sciencetek-song/fx10/STEP/BUZ_CMI-9705-0580-SMT-TR.step

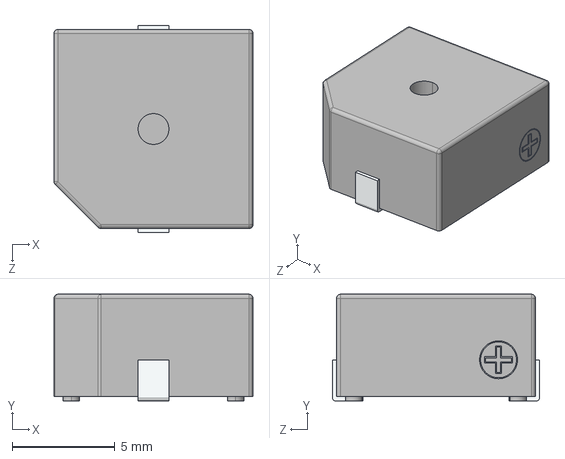
[picture p1: CAD file, 2025-09-14]
STEP/BUZ_CMI-9705-0580-SMT-TR.step
9.70 x 5.20 x 10.1 mm
