sciencetek-song/fx10/STEP/W25Q256JVEIQ.step

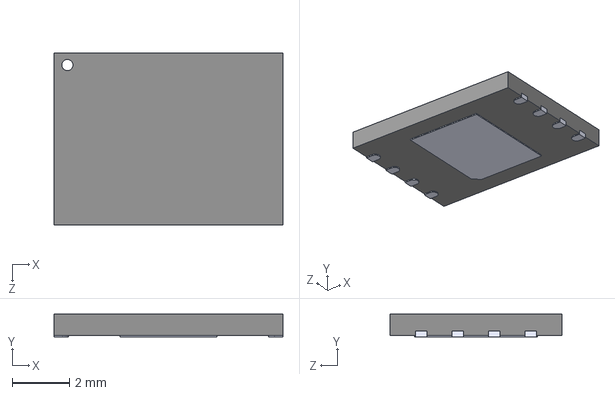
[picture p2: CAD file, 2025-09-14]
STEP/W25Q256JVEIQ.step
8.00 x 0.8 x 6.00 mm
