sciencetek-song/fx10/STEP/SMD14P.stp

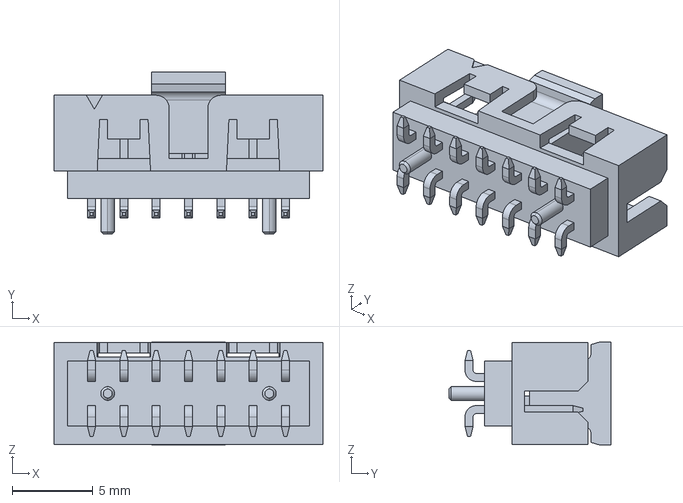
[picture p3: CAD file, 2025-09-14]
STEP/SMD14P.stp
16.6 x 10.0 x 6.35 mm
