sciencetek-song/fx10/STEP/TEST-PIN.step

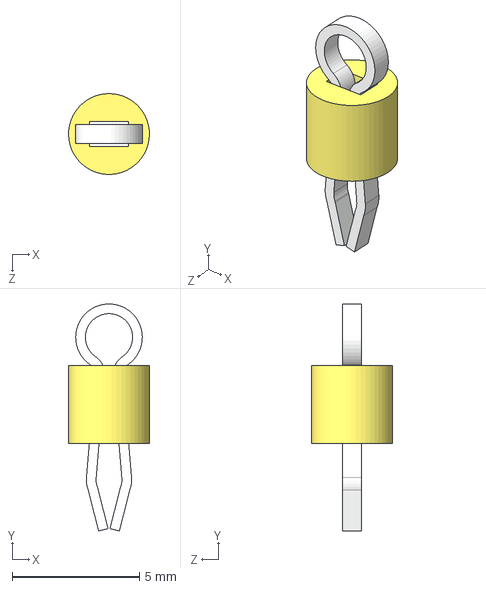
[picture p4: CAD file, 2025-09-14]
STEP/TEST-PIN.step
3.17 x 8.91 x 3.17 mm
