sciencetek-song/fx10/STEP/DS1307Z_.step

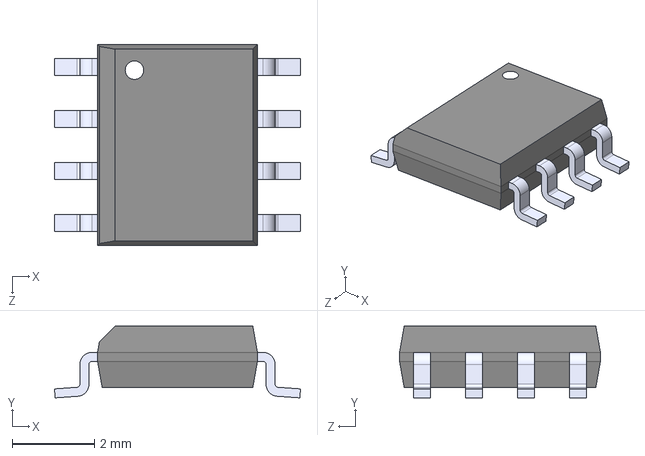
[picture p5: CAD file, 2025-09-14]
STEP/DS1307Z_.step
6.00 x 1.75 x 4.90 mm
