sciencetek-song/fx10/STEP/10UH.step

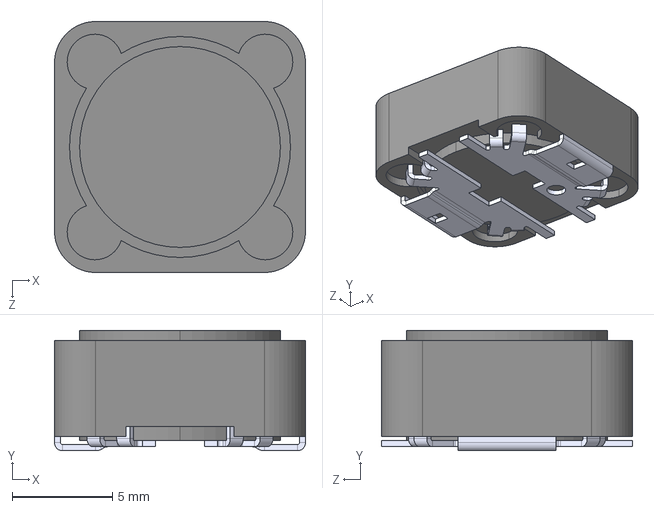
[picture p6: CAD file, 2025-09-14]
STEP/10UH.step
12.5 x 6.00 x 12.5 mm
