sciencetek-song/fx10/STEP/USBLC6-2SC6.step

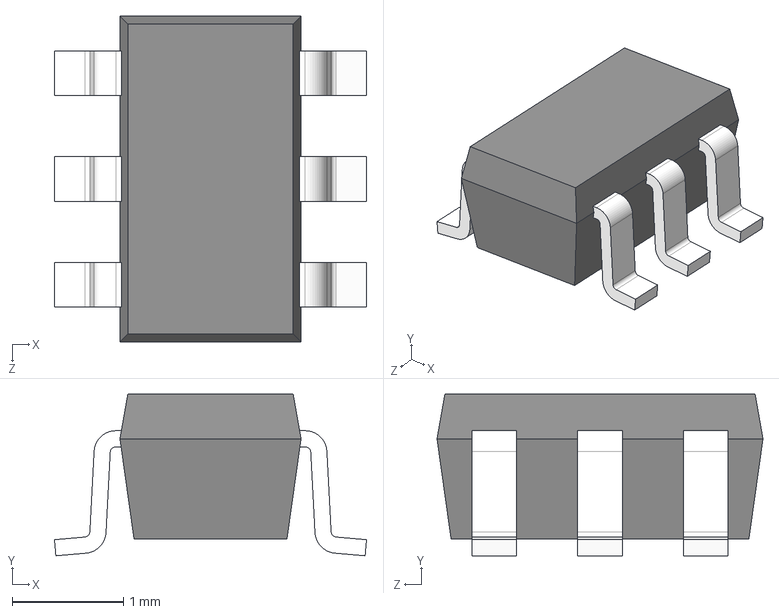
[picture p7: CAD file, 2025-09-14]
STEP/USBLC6-2SC6.step
2.80 x 1.45 x 2.92 mm
