sciencetek-song/fx10/STEP/LT3014ES5_TRPBF.step

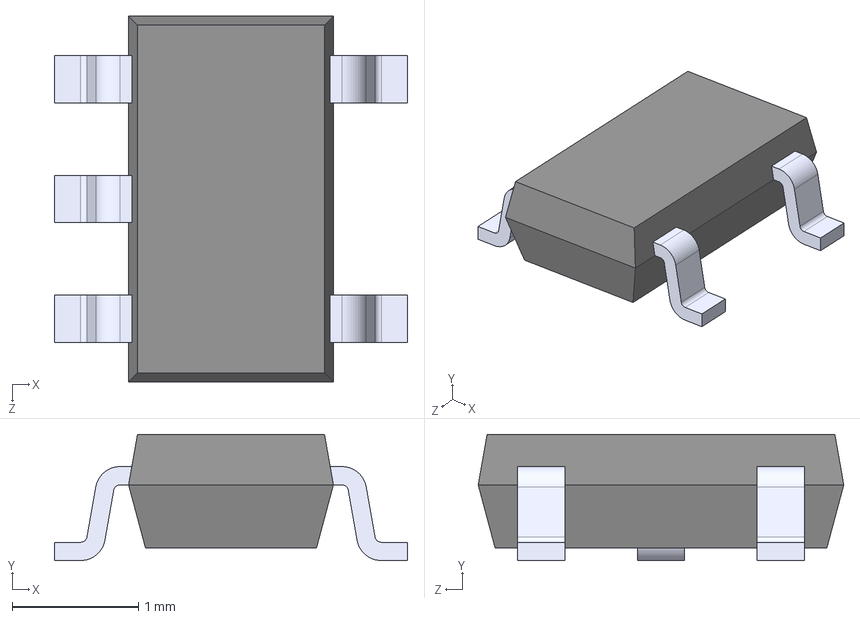
[picture p8: CAD file, 2025-09-14]
STEP/LT3014ES5_TRPBF.step
2.80 x 1.00 x 2.90 mm
