sciencetek-song/fx10/STEP/SDCARD-MOLEX.step

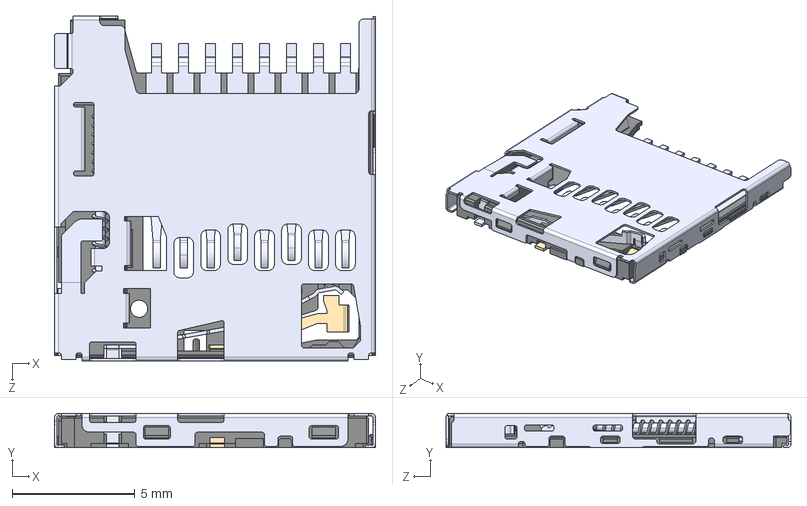
[picture p9: CAD file, 2025-09-14]
STEP/SDCARD-MOLEX.step
13.1 x 1.40 x 14.1 mm
