sciencetek-song/fx10/STEP/SS34.step

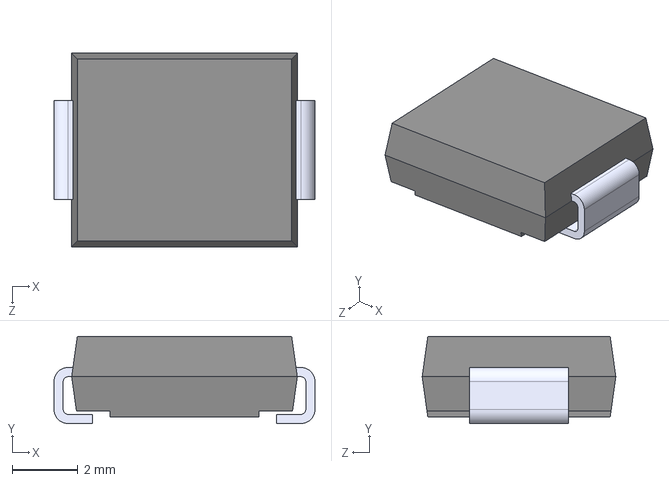
[picture p10: CAD file, 2025-09-14]
STEP/SS34.step
7.95 x 2.65 x 5.90 mm
