sciencetek-song/fx10/STEP/ADM8660ARZ-REEL.step

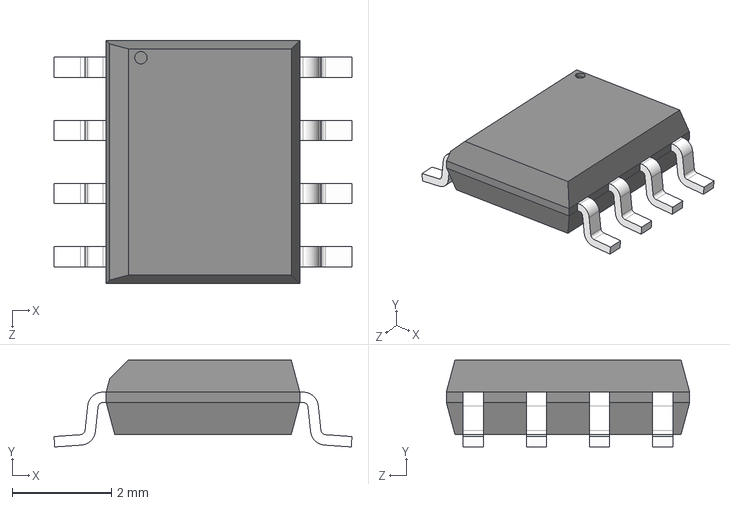
[picture p11: CAD file, 2025-09-14]
STEP/ADM8660ARZ-REEL.step
6.00 x 1.75 x 4.90 mm
