sciencetek-song/fx10/STEP/MMSZ5248BS-7-F.step

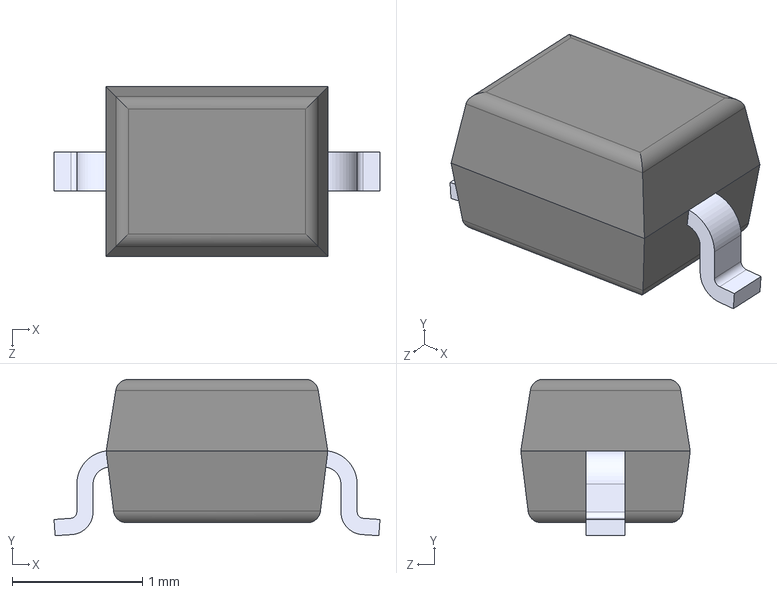
[picture p12: CAD file, 2025-09-14]
STEP/MMSZ5248BS-7-F.step
2.50 x 1.20 x 1.30 mm
