sciencetek-song/fx10/STEP/BLM18PG121SN1D.step

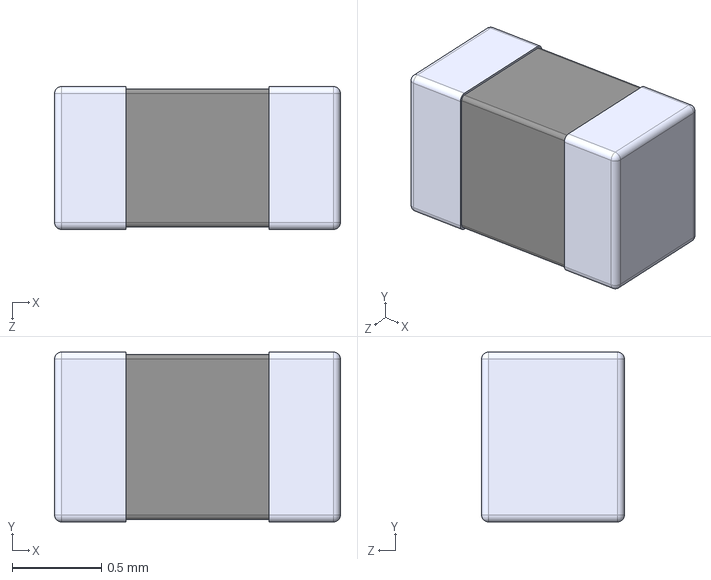
[picture p13: CAD file, 2025-09-14]
STEP/BLM18PG121SN1D.step
1.60 x 0.95 x 0.8 mm
