sciencetek-song/fx10/STEP/USBR-A-S-S-O-TH.stp

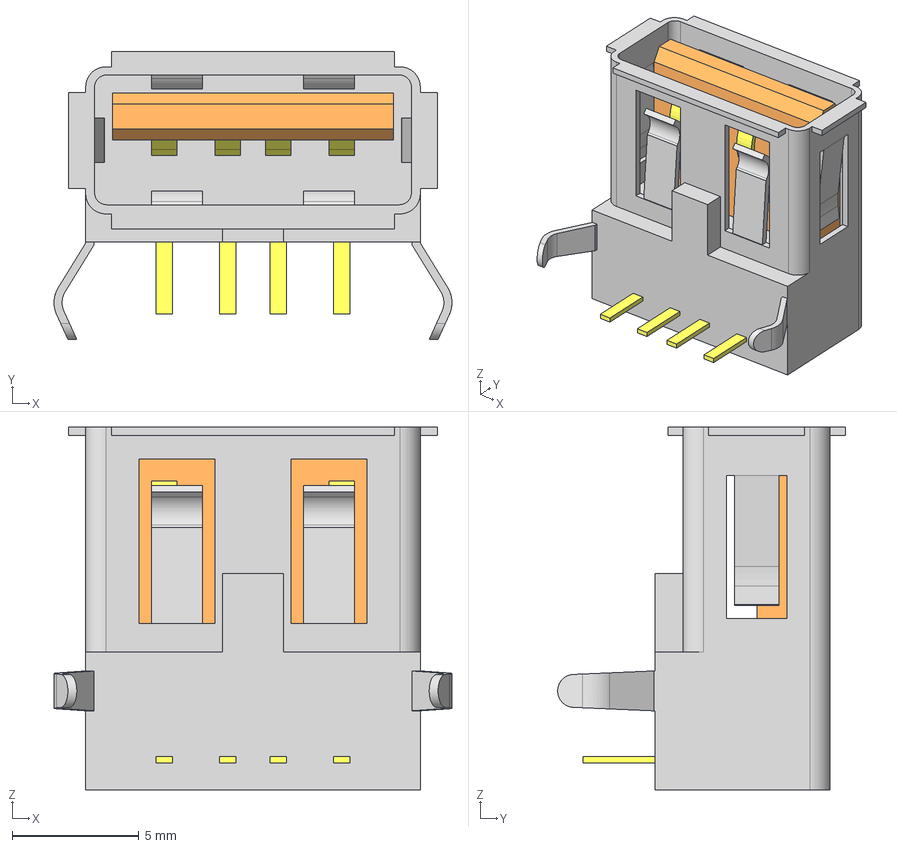
[picture p14: CAD file, 2025-09-14]
STEP/USBR-A-S-S-O-TH.stp
15.7 x 11.3 x 14.3 mm
USBR-A-S-TH_s
USBR-A-S-TH_b
USBR-A-S-TH_p
