sciencetek-song/fx10/STEP/BOX5x2_ANGLE2MM.step

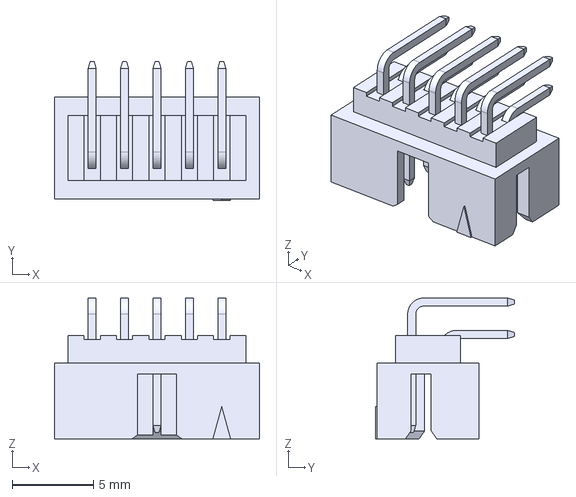
[picture p15: CAD file, 2025-09-14]
STEP/BOX5x2_ANGLE2MM.step
12.6 x 8.60 x 8.70 mm
