sciencetek-song/fx10/STEP/5267-02A-X.step

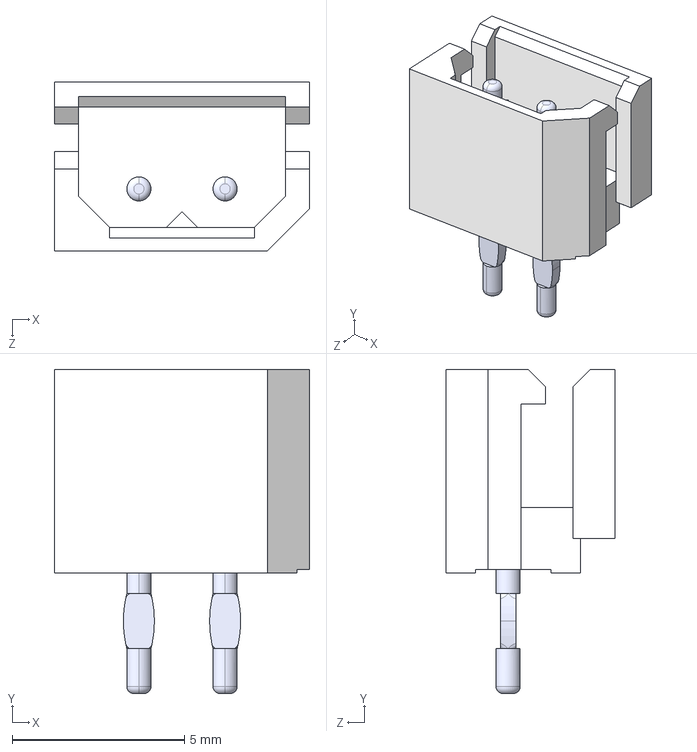
[picture p16: CAD file, 2025-09-14]
STEP/5267-02A-X.step
7.40 x 9.40 x 4.90 mm
