sciencetek-song/fx10/STEP/MMBT4401.step

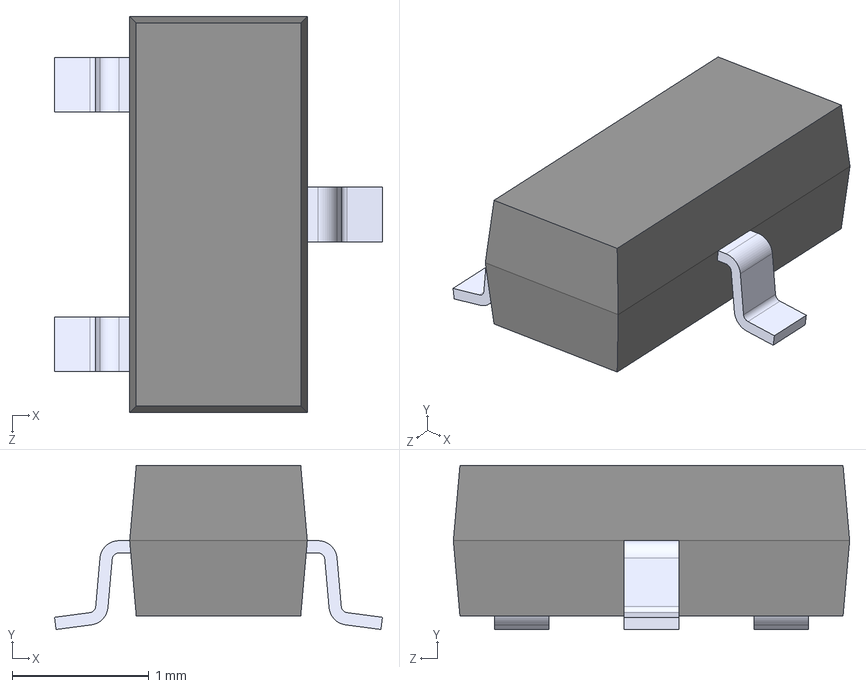
[picture p17: CAD file, 2025-09-14]
STEP/MMBT4401.step
2.40 x 1.20 x 2.90 mm
