sciencetek-song/fx10/STEP/BNX002-11.step

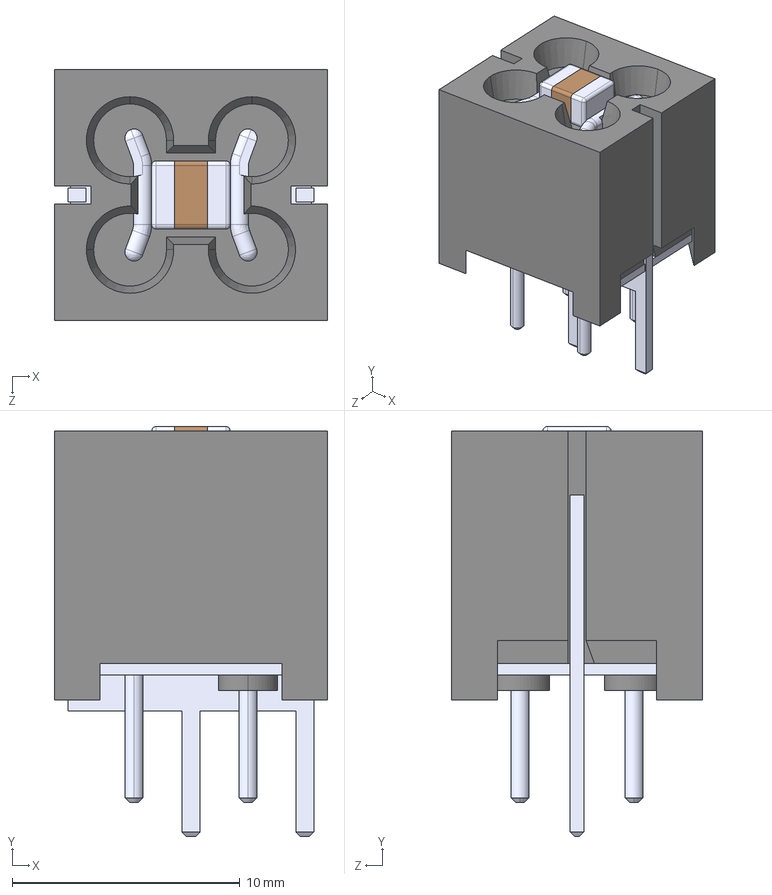
[picture p18: CAD file, 2025-09-14]
STEP/BNX002-11.step
12.0 x 18.0 x 11.0 mm
