sciencetek-song/fx10/STEP/AT24C512C-SSHD-T.step

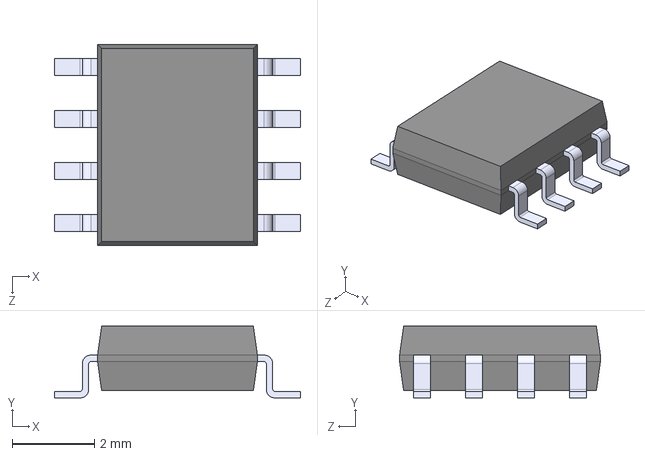
[picture p19: CAD file, 2025-09-14]
STEP/AT24C512C-SSHD-T.step
6.00 x 1.75 x 4.90 mm
