sciencetek-song/fx10/STEP/3.6uH.step

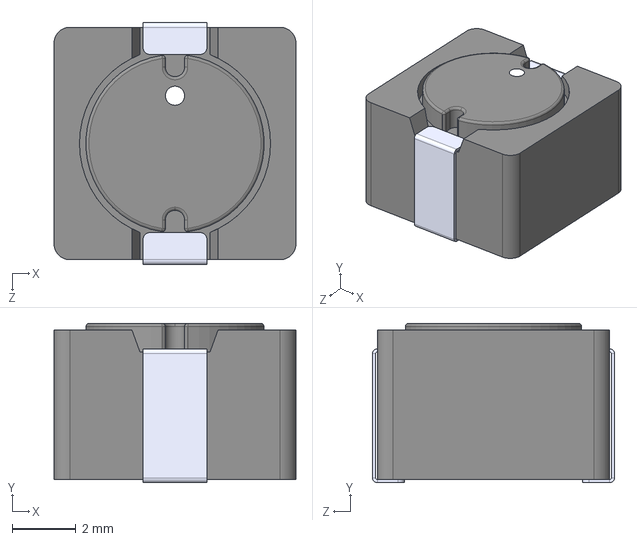
[picture p20: CAD file, 2025-09-14]
STEP/3.6uH.step
7.60 x 5.00 x 7.60 mm
