sciencetek-song/fx10/STEP/WA-SMSE_9771XXX360.step

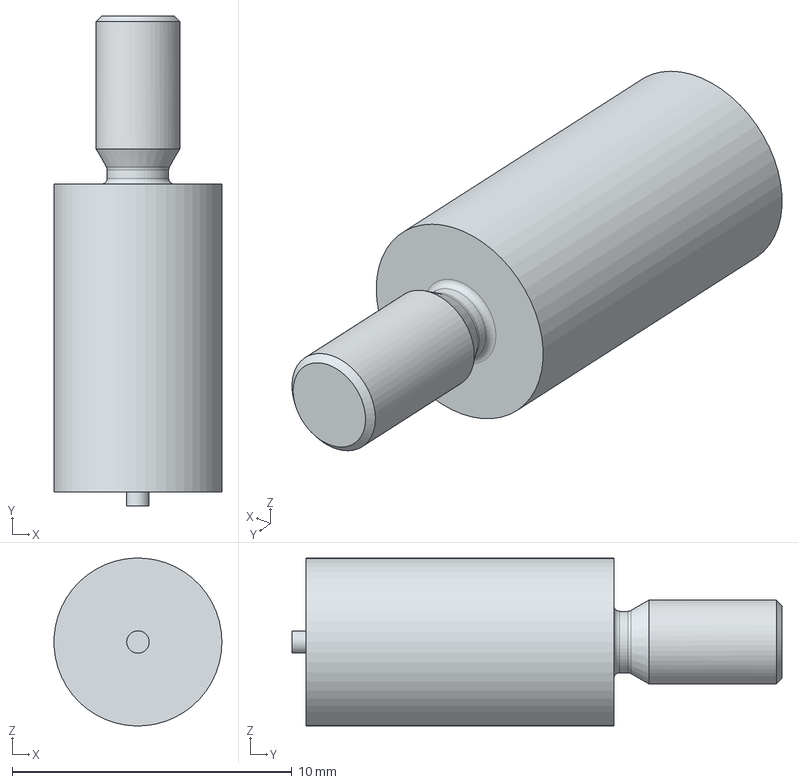
[picture p21: CAD file, 2025-09-14]
STEP/WA-SMSE_9771XXX360.step
5.99 x 17.5 x 6.00 mm
