sciencetek-song/fx10/STEP/USBR-B-S-S-O-TH.stp

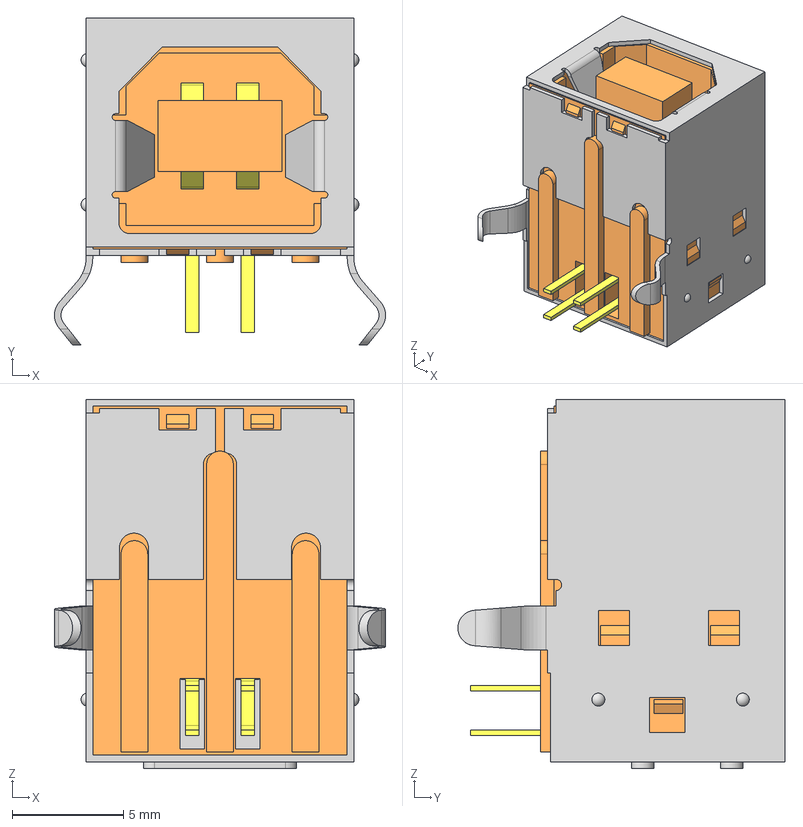
[picture p22: CAD file, 2025-09-14]
STEP/USBR-B-S-S-O-TH.stp
14.9 x 14.7 x 16.6 mm
USBR-B-S-TH_s
USBR-B-S-TH_b
USBR-B-S-TH_p
