sciencetek-song/fx10/STEP/DIN48-PRESSFIT.stp

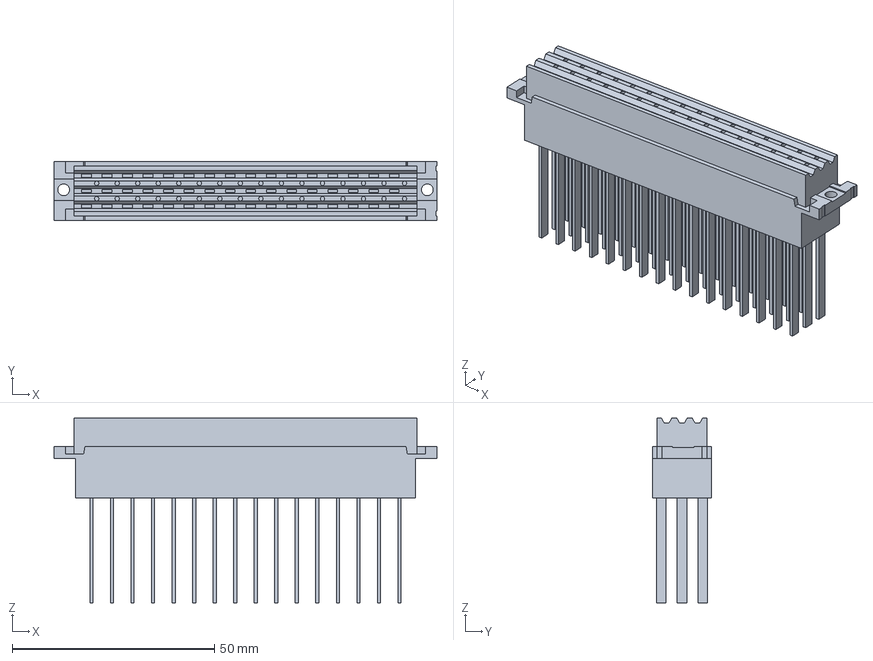
[picture p23: CAD file, 2025-09-14]
STEP/DIN48-PRESSFIT.stp
94.8 x 14.7 x 45.8 mm
