sciencetek-song/fx10/STEP/COIL.stp

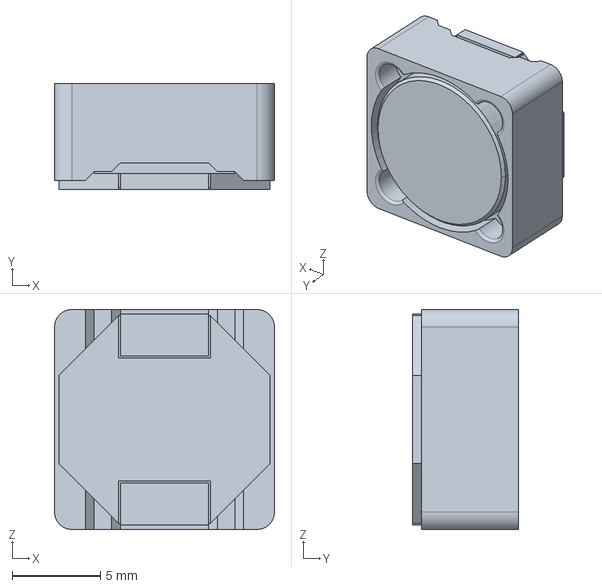
[picture p24: CAD file, 2025-09-14]
STEP/COIL.stp
12.5 x 6.00 x 12.5 mm
