sciencetek-song/fx10/STEP/CR1220.step

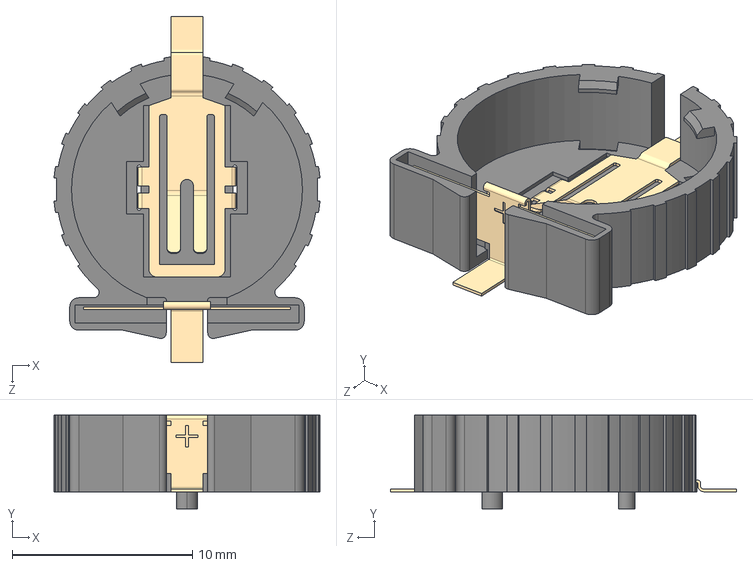
[picture p25: CAD file, 2025-09-14]
STEP/CR1220.step
14.7 x 5.20 x 19.2 mm
