sciencetek-song/fx10/STEP/SMAJ24A.step

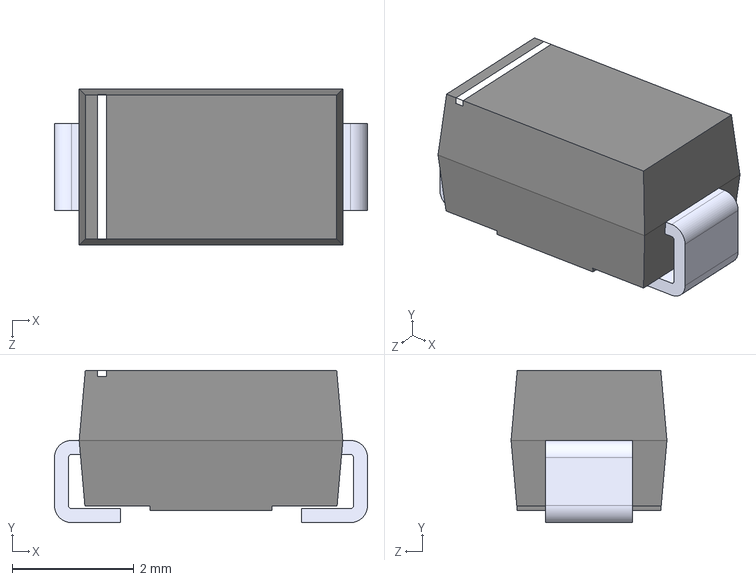
[picture p26: CAD file, 2025-09-14]
STEP/SMAJ24A.step
5.14 x 2.50 x 2.56 mm
