sciencetek-song/fx10/STEP/W9825G6KH-6.step

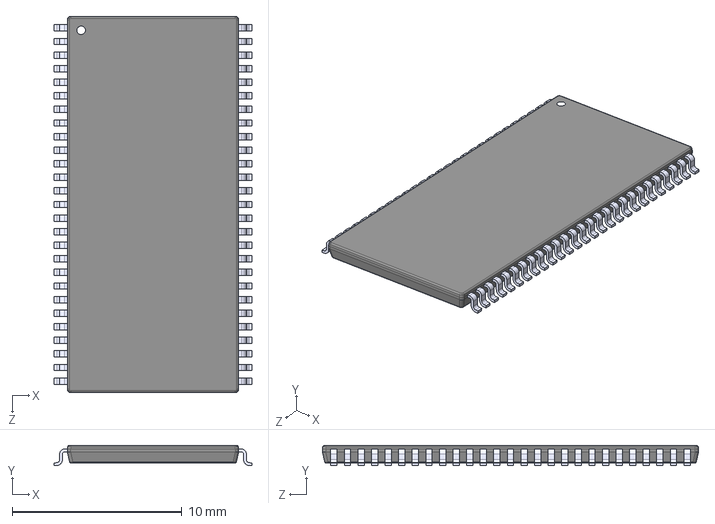
[picture p27: CAD file, 2025-09-14]
STEP/W9825G6KH-6.step
11.7 x 1.20 x 22.2 mm
