sciencetek-song/fx10/STEP/CM7V-T1A-32.768KHZ-12.5PF-100PPM-TC-QC.step

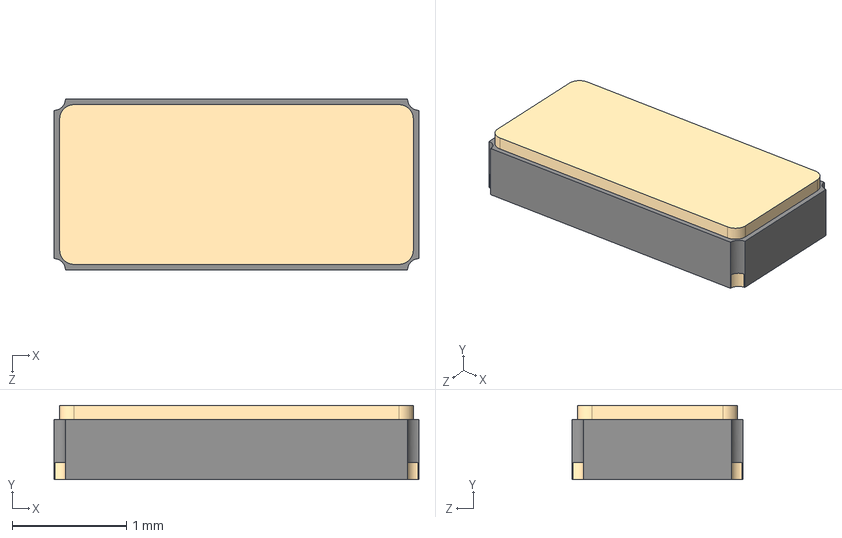
[picture p28: CAD file, 2025-09-14]
STEP/CM7V-T1A-32.768KHZ-12.5PF-100PPM-TC-QC.step
3.20 x 0.65 x 1.50 mm
