sciencetek-song/fx10/STEP/CH340N.step

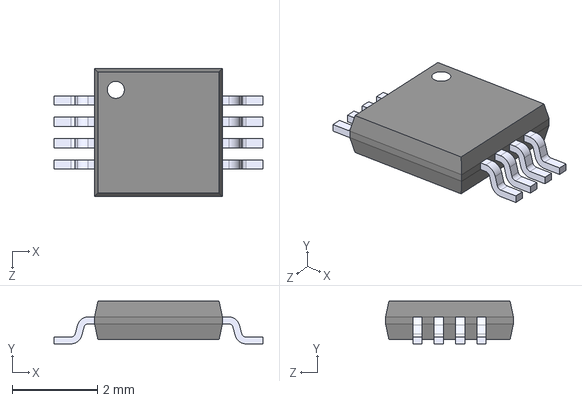
[picture p29: CAD file, 2025-09-14]
STEP/CH340N.step
4.90 x 1 x 3.00 mm
