sciencetek-song/fx10/STEP/SMD-LED.step

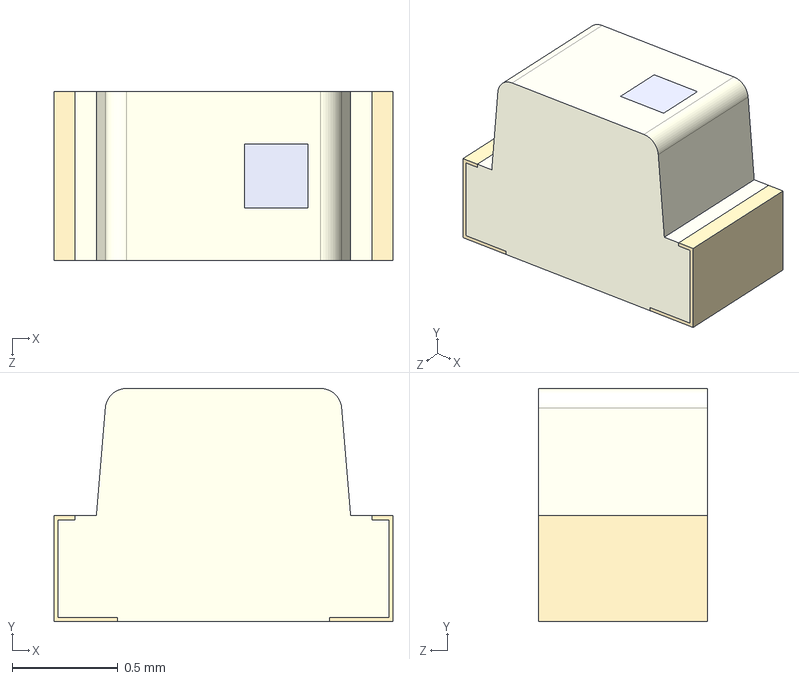
[picture p30: CAD file, 2025-09-14]
STEP/SMD-LED.step
1.60 x 1.10 x 0.8 mm
