sciencetek-song/fx10/STEP/FPC14-0.5mm-HRS.step

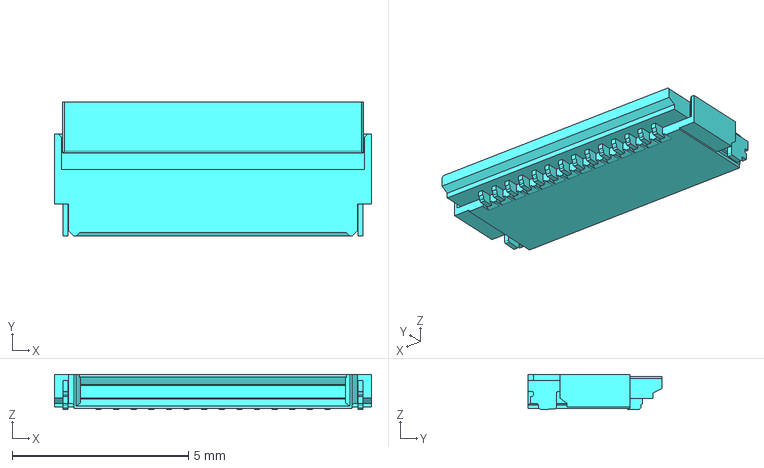
[picture p31: CAD file, 2025-09-14]
STEP/FPC14-0.5mm-HRS.step
9.00 x 3.80 x 1.00 mm
