sciencetek-song/fx10/STEP/LTC4359CMS8_TRPBF.step

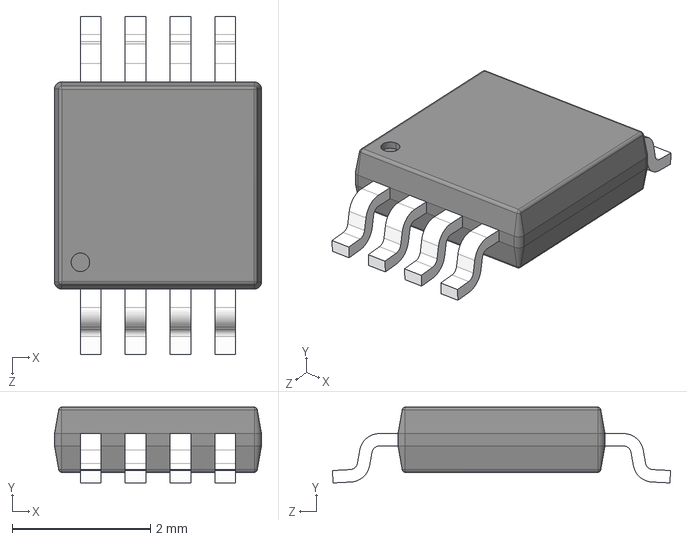
[picture p32: CAD file, 2025-09-14]
STEP/LTC4359CMS8_TRPBF.step
3.00 x 1.10 x 4.90 mm
