sciencetek-song/fx10/STEP/LT1763IS8_PBF.step

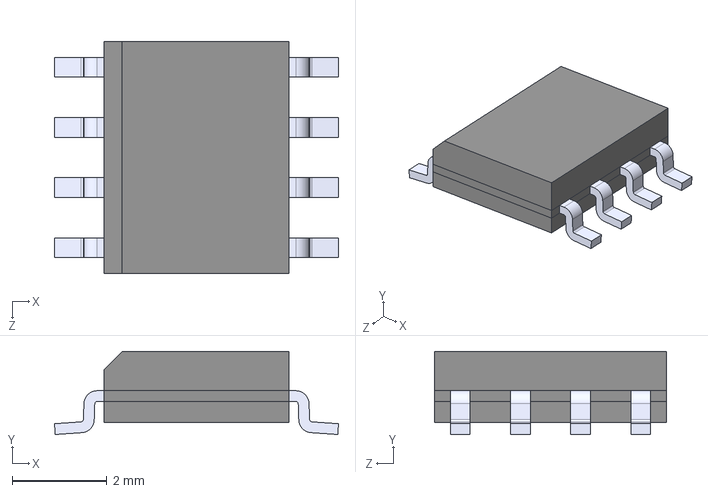
[picture p33: CAD file, 2025-09-14]
STEP/LT1763IS8_PBF.step
5.99 x 1.75 x 4.90 mm
