sciencetek-song/fx10/STEP/FPC14-0.5mm.step

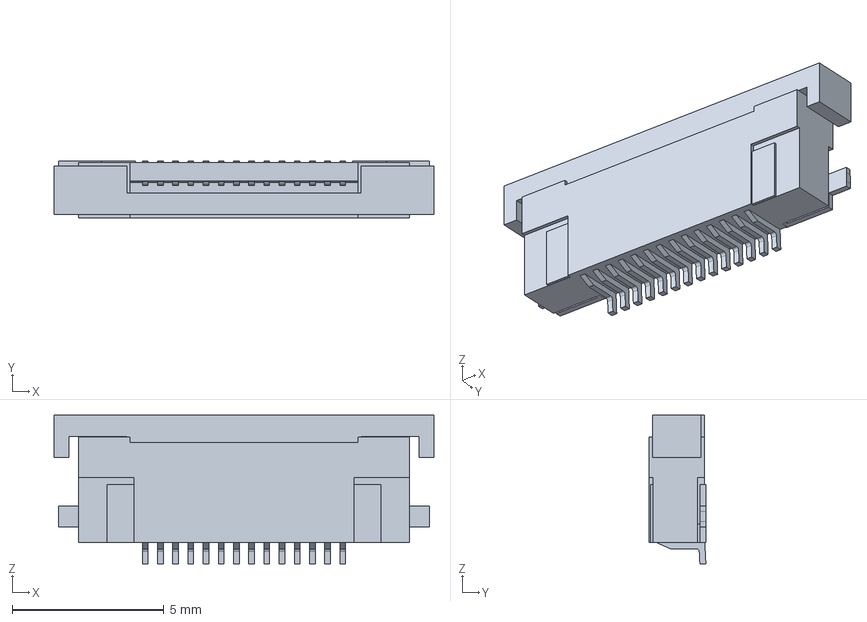
[picture p34: CAD file, 2025-09-14]
STEP/FPC14-0.5mm.step
12.5 x 1.87 x 4.90 mm
