sciencetek-song/fx10/STEP/BLM41PG600SN1B.step

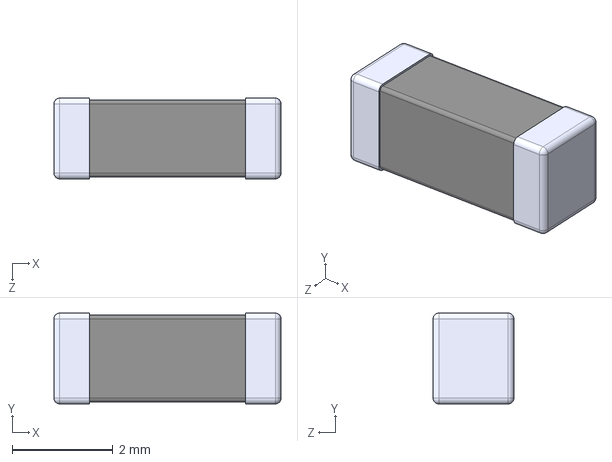
[picture p35: CAD file, 2025-09-14]
STEP/BLM41PG600SN1B.step
4.50 x 1.80 x 1.60 mm
