sciencetek-song/fx10/STEP/406AF-48-FSS-BAB4.step

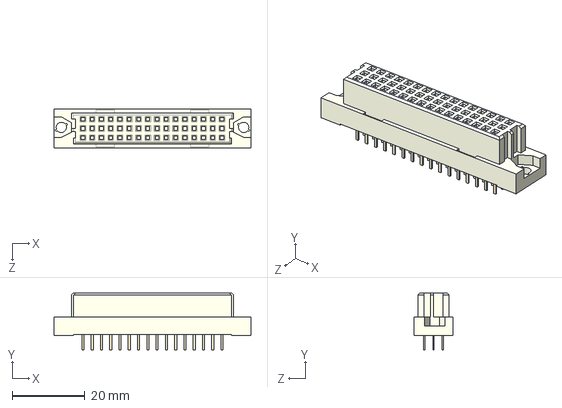
[picture p36: CAD file, 2025-09-14]
STEP/406AF-48-FSS-BAB4.step
54.0 x 15.6 x 10.6 mm
