sciencetek-song/fx10/STEP/SI4431DY-T1-E3.STEP

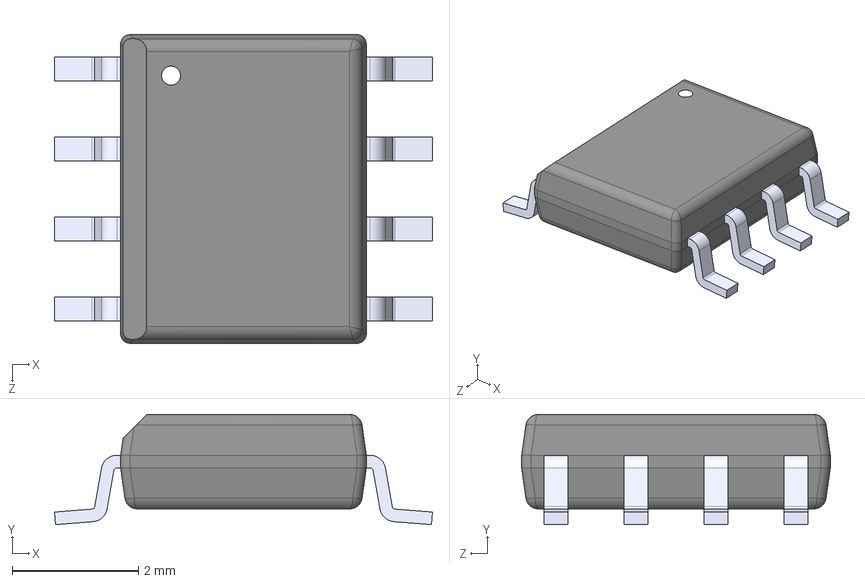
[picture p37: CAD file, 2025-09-14]
STEP/SI4431DY-T1-E3.STEP
6.00 x 1.75 x 4.90 mm
