sciencetek-song/fx10/STEP/COIL5x5.step

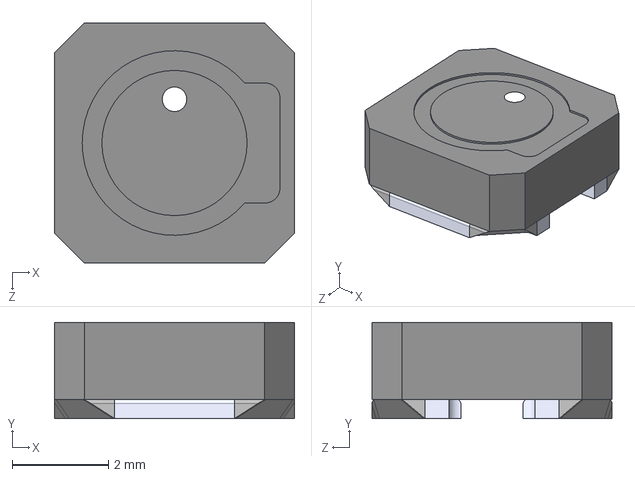
[picture p38: CAD file, 2025-09-14]
STEP/COIL5x5.step
5.00 x 2.00 x 5.00 mm
