sciencetek-song/fx10/STEP/ADS1110A0IDBVT.step

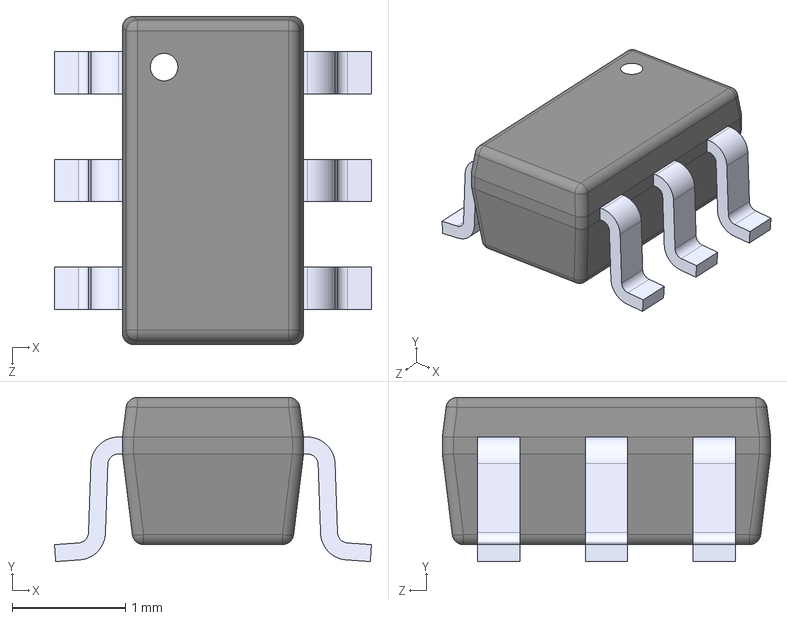
[picture p39: CAD file, 2025-09-14]
STEP/ADS1110A0IDBVT.step
2.80 x 1.45 x 2.90 mm
