sciencetek-song/fx10/STEP/PCB-POST.step

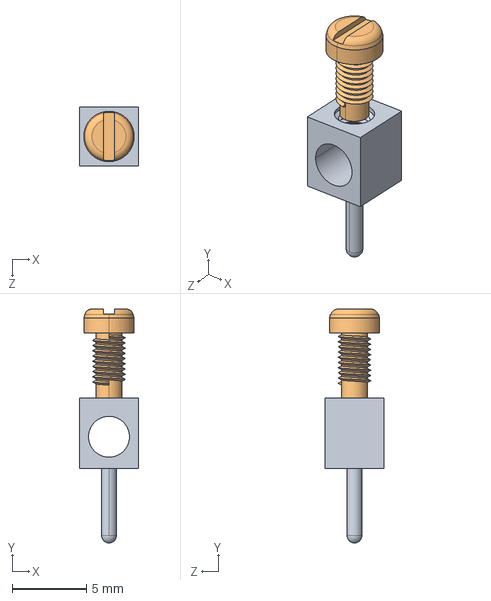
[picture p40: CAD file, 2025-09-14]
STEP/PCB-POST.step
4.00 x 15.8 x 4.00 mm
