sciencetek-song/fx10/STEP/DAC8560ICDGKR.step

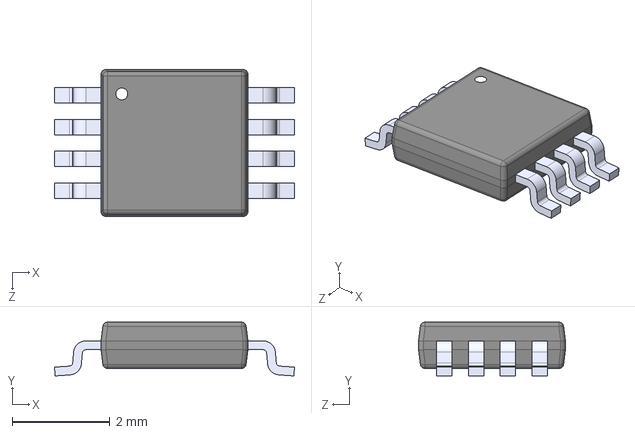
[picture p41: CAD file, 2025-09-14]
STEP/DAC8560ICDGKR.step
4.90 x 1.10 x 3.00 mm
