sciencetek-song/fx10/STEP/LTC4008EGNPBF.step

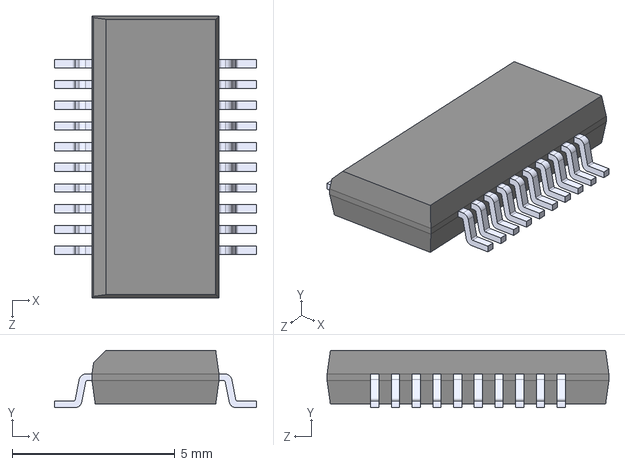
[picture p42: CAD file, 2025-09-14]
STEP/LTC4008EGNPBF.step
6.20 x 1.75 x 8.65 mm
