sciencetek-song/fx10/STEP/TMUX4052PWR--3DModel-STEP-56544.STEP

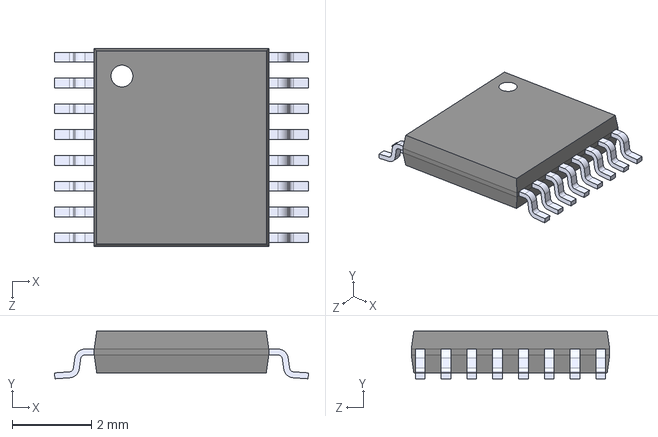
[picture p43: CAD file, 2025-09-14]
STEP/TMUX4052PWR--3DModel-STEP-56544.STEP
6.40 x 1.20 x 5.00 mm
