sciencetek-song/fx10/STEP/STM1001TWX6F.step

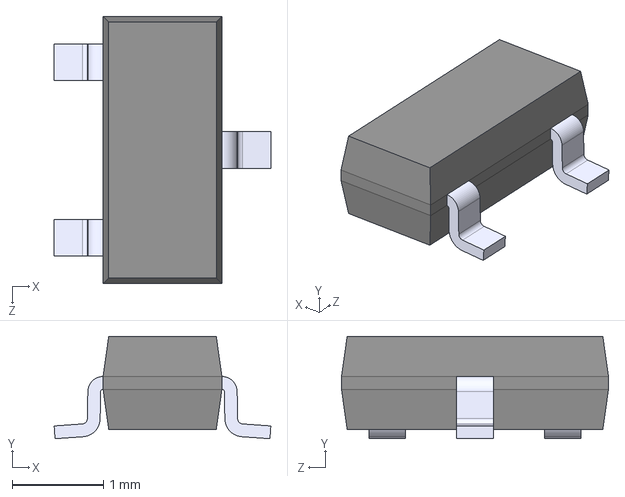
[picture p44: CAD file, 2025-09-14]
STEP/STM1001TWX6F.step
2.37 x 1.12 x 2.92 mm
