sciencetek-song/fx10/STEP/OPA2810IDT.step

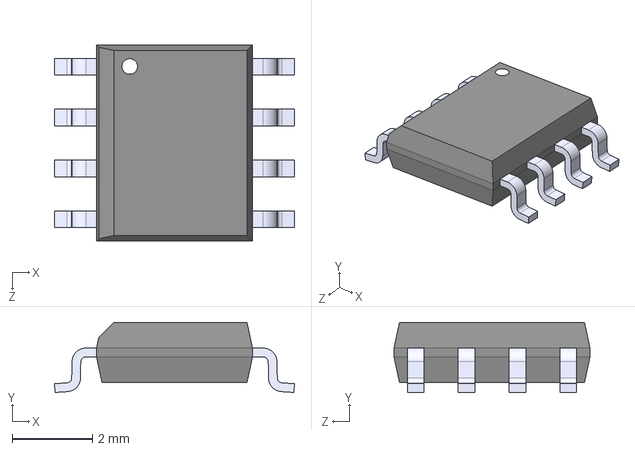
[picture p45: CAD file, 2025-09-14]
STEP/OPA2810IDT.step
6.00 x 1.75 x 4.90 mm
