sciencetek-song/fx10/STEP/1N5819HW-7-F.step

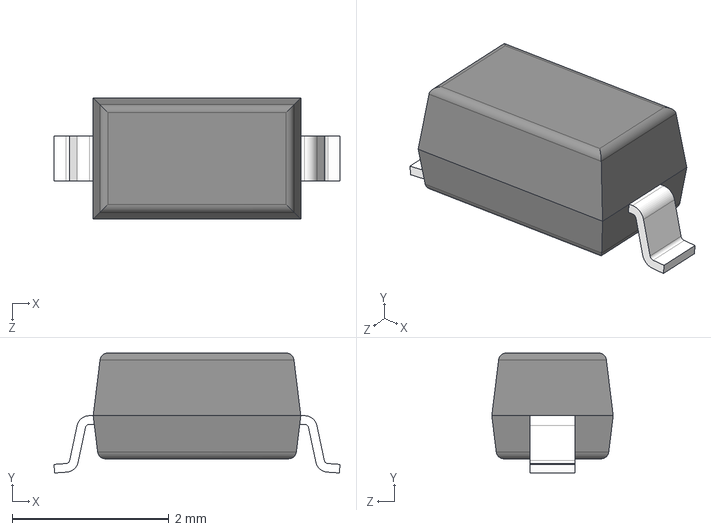
[picture p46: CAD file, 2025-09-14]
STEP/1N5819HW-7-F.step
3.65 x 1.53 x 1.55 mm
