sciencetek-song/fx10/STEP/IRFR1205TRPBF.step

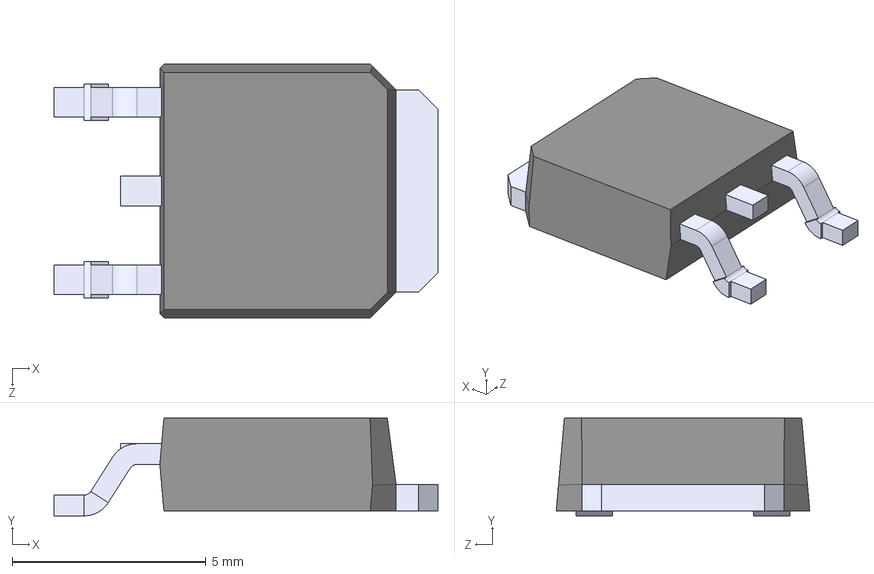
[picture p47: CAD file, 2025-09-14]
STEP/IRFR1205TRPBF.step
9.91 x 2.52 x 6.54 mm
