sciencetek-song/fx10/(list of files, cad)

Other CAD files:
STEP/AP22652W6-7.step
STEP/AP63200WU-7.step
STEP/AP64501SP-13.step
