sciencetek-song/fx10/(notices)

Notices in the files:
STEP/USBR-A-S-S-O-TH.stp:
author */ ('License CC BY-ND 4.0'),
